vpon-lab/514-Final-Project/Final Project Presentation.pptx

## Wireless Tape Measurer

Veronika Sermeno Pon
TECHIN 514
Final Project
Github Repo: https://github.com/vpon-lab/514-Final-Project

## Measuring alone

- Wanting to measure bedroom space on your own with out another person’s assistance.
- Mitigate sag from a physical tape measurer.

- Problem to Solve:

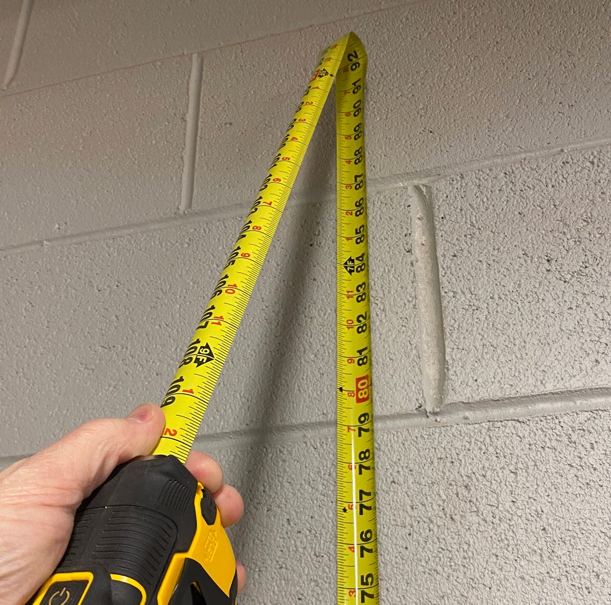
[picture p6: figure]
How to Use a Tape Measure: How to Measure With a Measuring Tape

## Measuring alone

- Wireless tape measurement
- 2-piece system to measure from point A to point B

- A proposed Solution:

General Sketch

Notes: Insert picture once prints are done

## System Architecture


## Sensing + Display Device

Due to multiple ESP32C3 Battery pad mishaps, this is not battery powered for cautionary measures

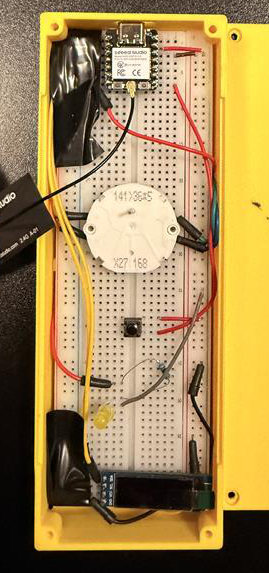
[picture p7: figure]

Display Device

XIAO ESP32C3

Time of Flight Laser Sensor

X27 Stepper Motor

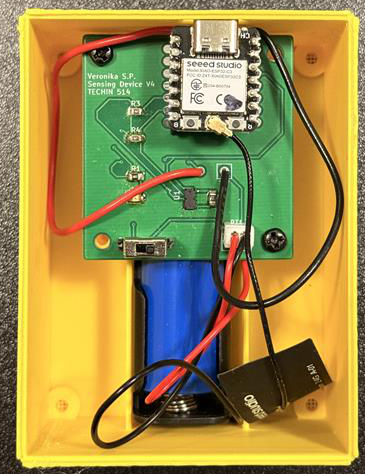
[picture p8: figure]

Sensor Device

“Tare” Button

Power On/Off Switch

OLED Display

Notes: Insert picture once prints are done

## Signal Processing

- Moving average filter, numbers were the same at the first decimal place before filter.
- Accuracy:
  - ±0.01 ft
  - ±3mm
  - Degrades with distance

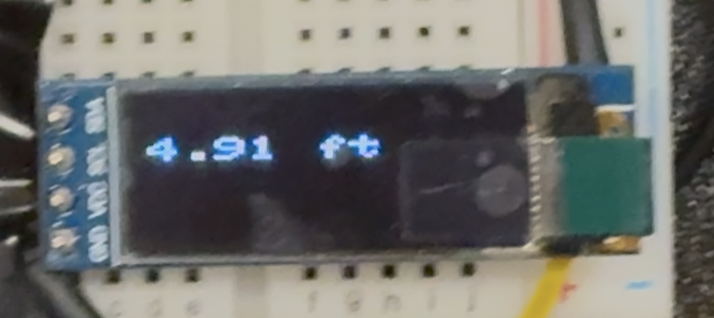
[picture p9: figure]

Display Device shows sensor jumping between measurements – from table to ceiling

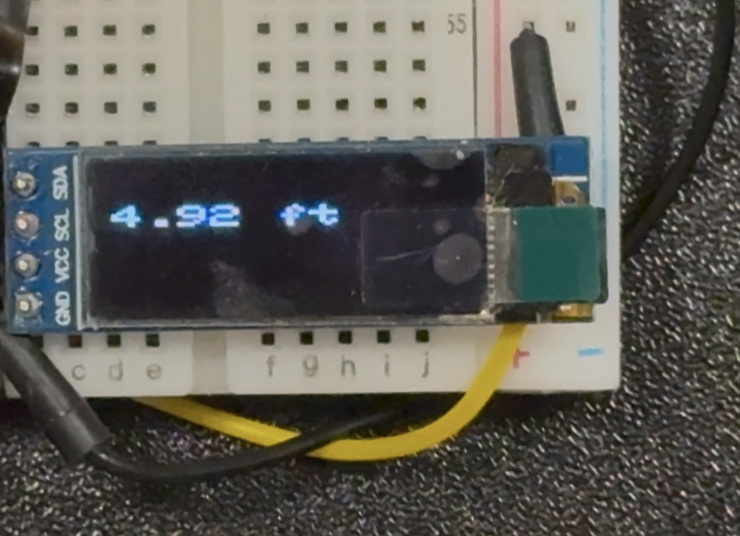
[picture p10: figure]

## Battery Considerations – Sensing device

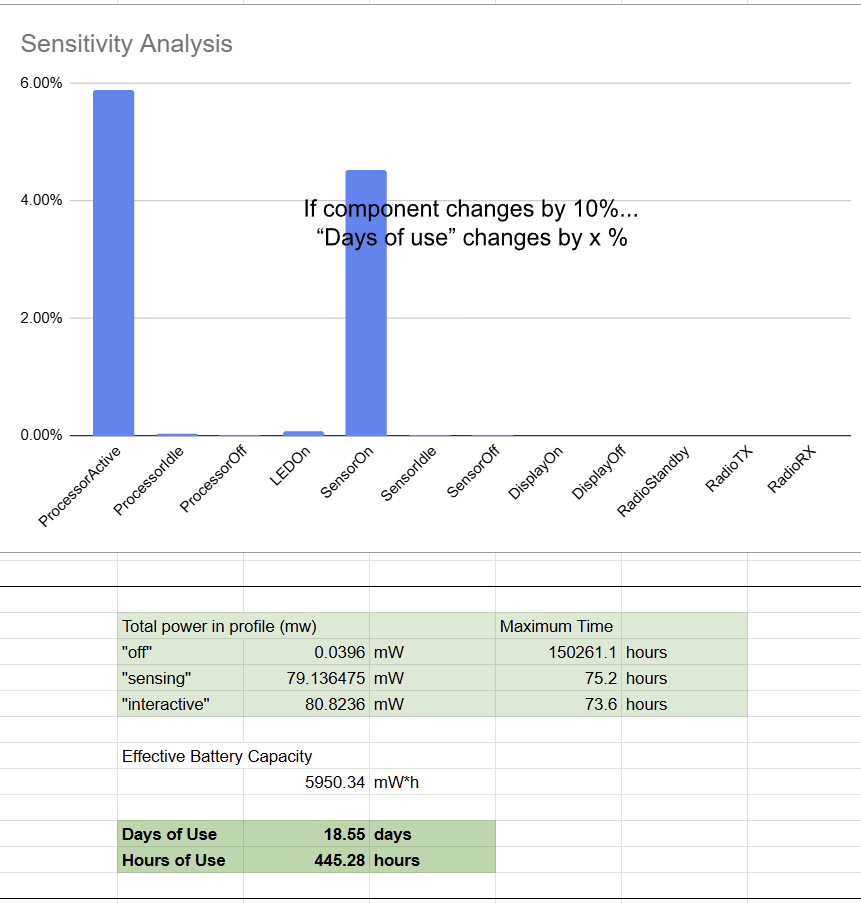
[picture p11: figure]

- 3.7V Lipo or Li-Ion Battery
- Compact easy to design with in enclosure and long lasting
- Based on 2hrs/day of use

## Appendix

- Budget Summary

Anything with “$0” was free in the Maker Space

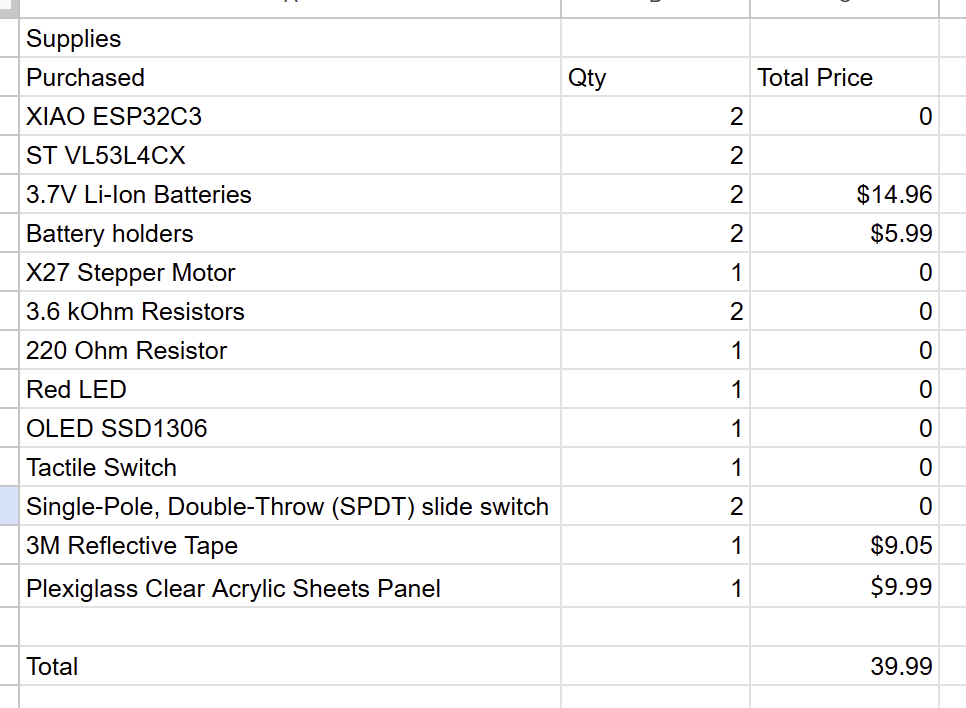
[picture p12: figure]

## Future Work

- Sensor Calibration to get rid of cross-talk from clear acrylic window.
- Sensor Calibration to find max capable distance based on Bluetooth connection compatibility
- Develop a more ergonomic and detachable/portable enclosure(s)
- Proper PCB design for easy battery connection to Display device.

## Appendix

- Power Model (Sensing Device)

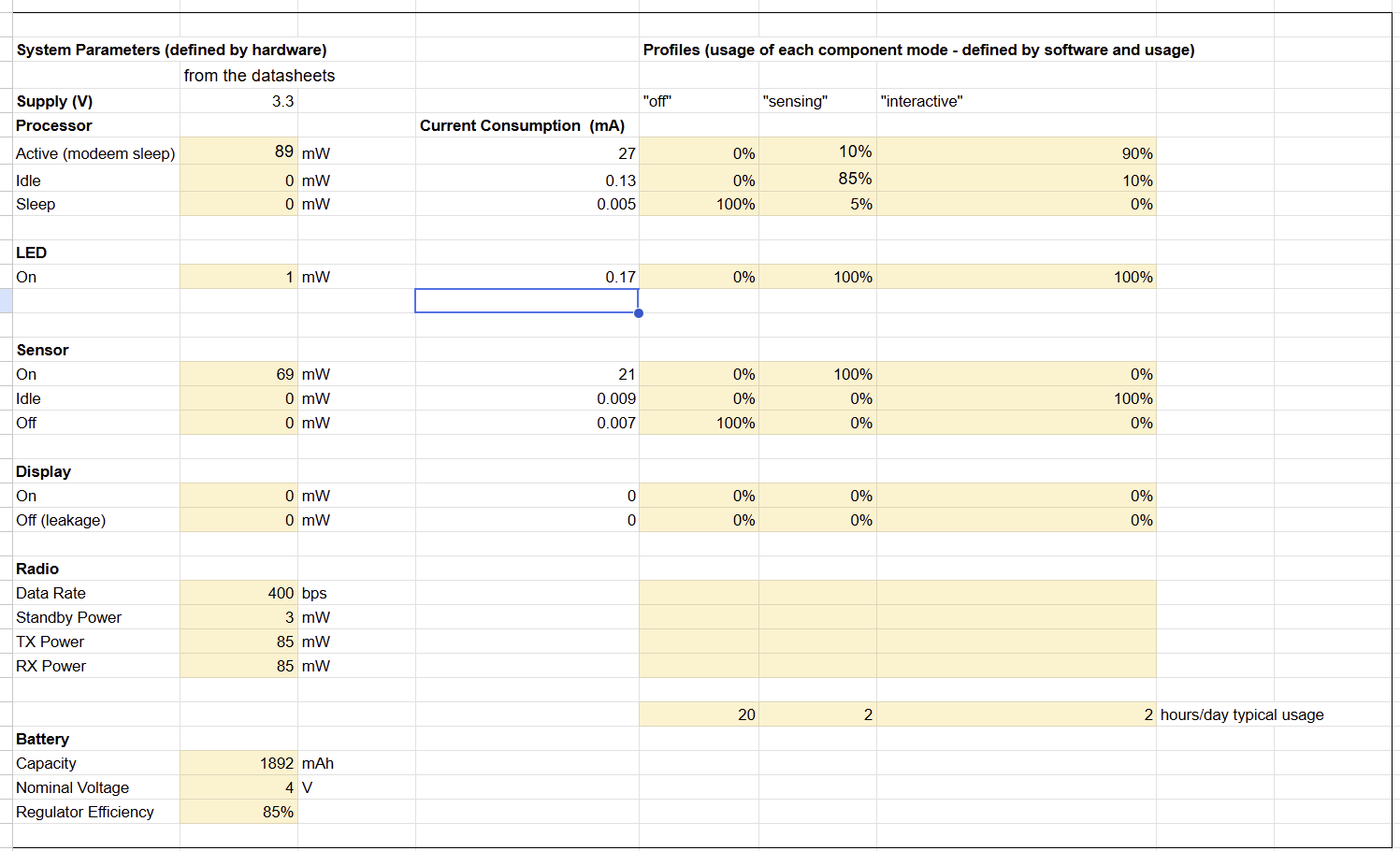
[picture p13: figure]

## Appendix

- Power Model (Display Device) if it were battery powered

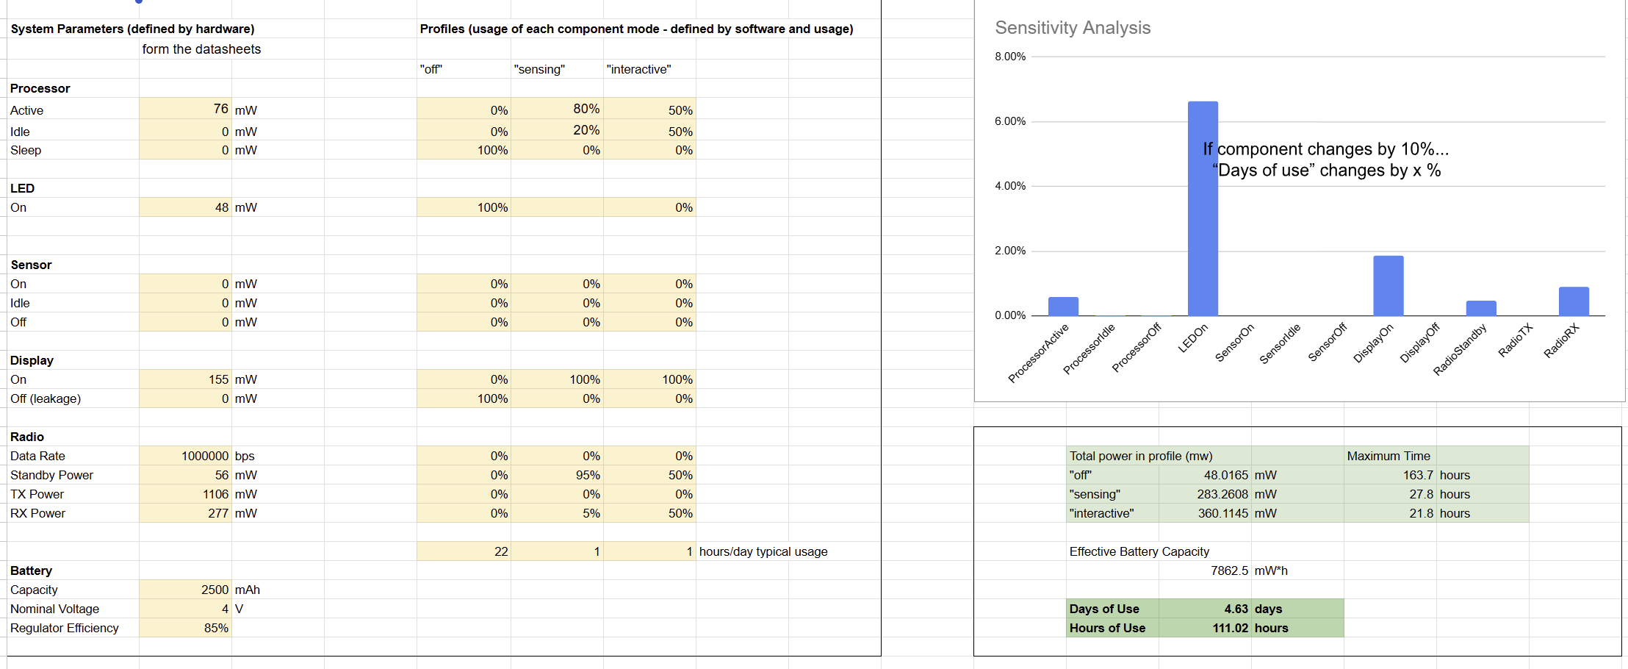
[picture p14: figure]

## Appendix

- Budget Summary

Anything with “$0” was free in the Maker Space

## Appendix

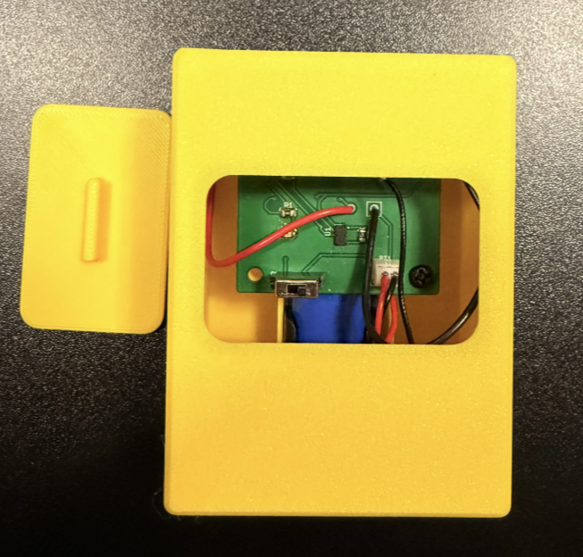
[picture p15: figure]

Sensor Device

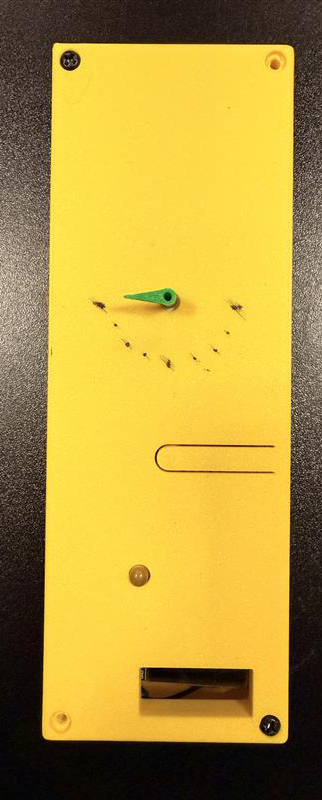
[picture p16: figure]

- Enclosure Design

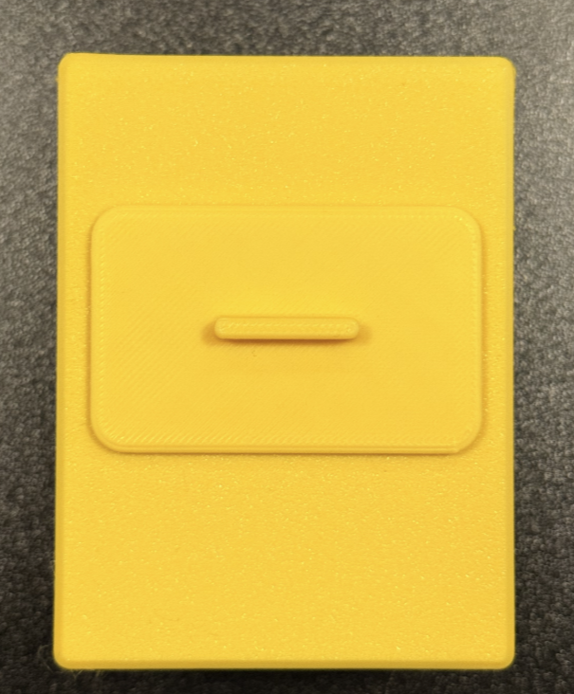
[picture p17: figure]

Display Device

Due to multiple ESP32C3 Battery pad mishaps, this is not battery powered for cautionary measures
