vpon-lab/514-Final-Project/Electrical_schematics/Schematics_display_deviceV3/SensingDevice_V4 (Assembly).step

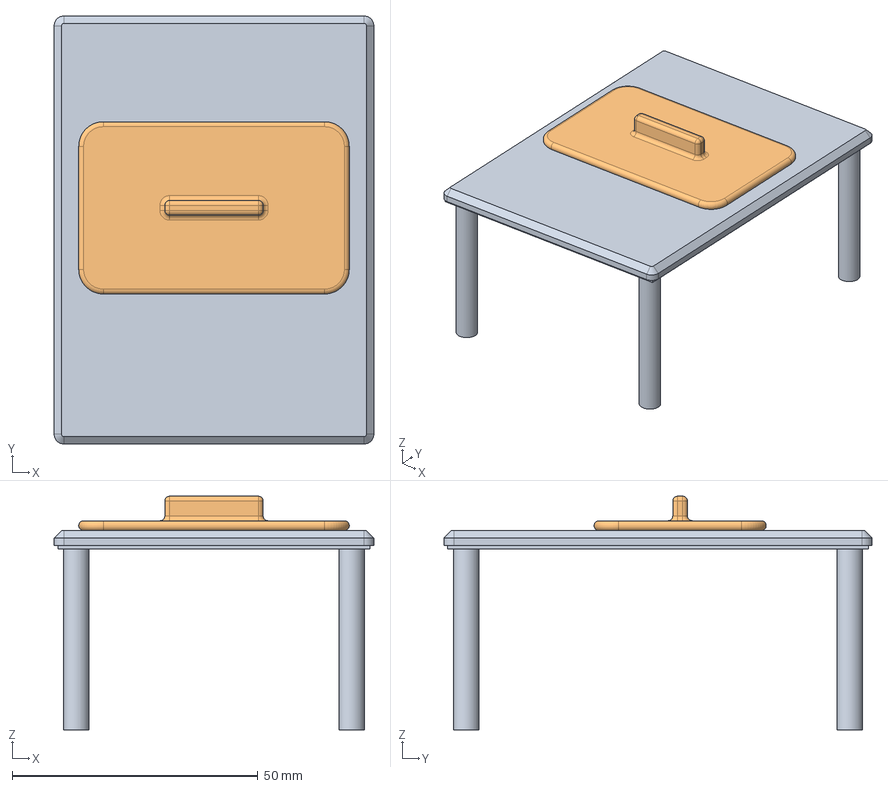
[picture p22: CAD file, 2026-03-16]
Electrical_schematics/Schematics_display_deviceV3/SensingDevice_V4 (Assembly).step
65.0 x 87.0 x 47.5 mm
