vpon-lab/514-Final-Project/Electrical_schematics/Electrical_schematics_V4/SensingDevice_V4 (Assembly).step

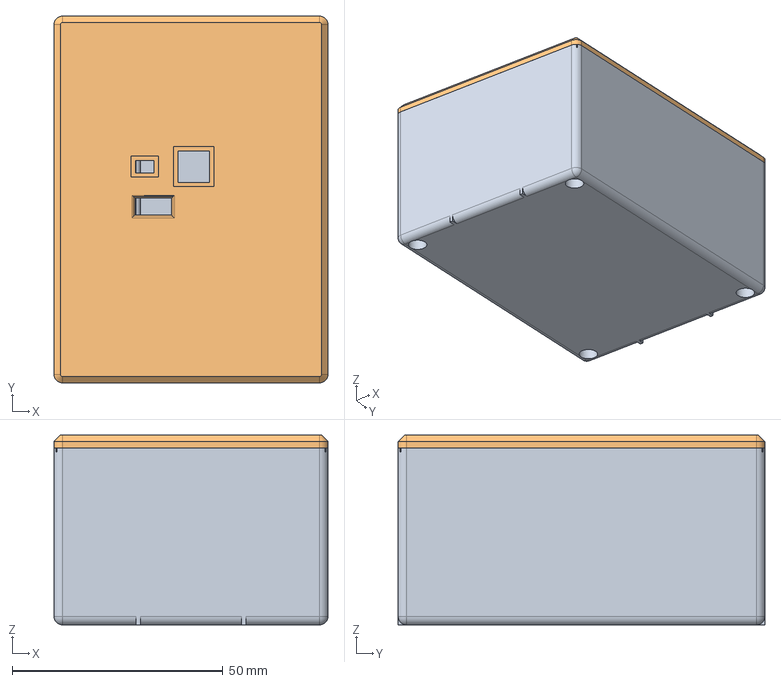
[picture p23: CAD file, 2026-03-16]
Electrical_schematics/Electrical_schematics_V4/SensingDevice_V4 (Assembly).step
65.0 x 87.0 x 45.0 mm
