vpon-lab/514-Final-Project/Electrical_schematics/Schematics_display_deviceV3/DisplayDeviceEnclosure.step

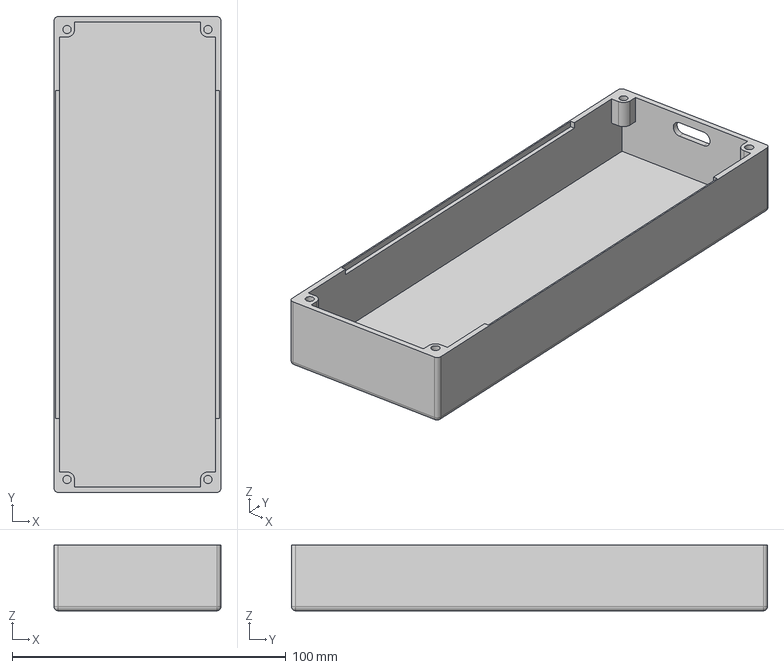
[picture p24: CAD file, 2026-03-16]
Electrical_schematics/Schematics_display_deviceV3/DisplayDeviceEnclosure.step
61.0 x 174.0 x 24.0 mm
