vpon-lab/514-Final-Project/Electrical_schematics/Schematics_display_deviceV3/Schematics_display_deviceV3.step

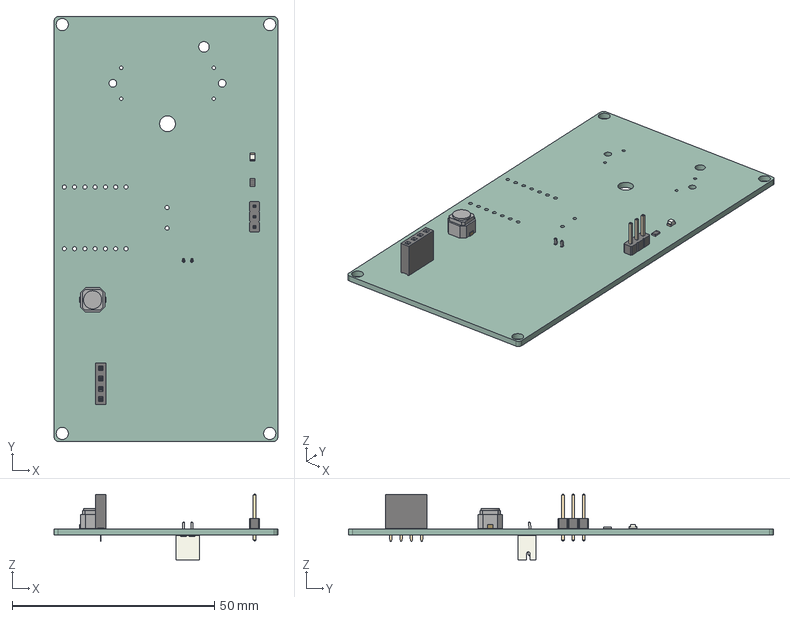
[picture p25: CAD file, 2026-03-16]
Electrical_schematics/Schematics_display_deviceV3/Schematics_display_deviceV3.step
55.2 x 105.0 x 16.2 mm
pin_1
pin_2
LED_0805_2012Metric
PinSocket_1x04_P2.54mm_Vertical
PinHeader_1x03_P2.54mm_Vertical
R_0805_2012Metric
JST_PH_B2B-PH-K_1x02_P2.00mm_Vertical
Schematics_display_deviceV3_PCB
