vpon-lab/514-Final-Project/Electrical_schematics/Schematics_display_deviceV3/DisplayDeviceEnclosure (Needle).step

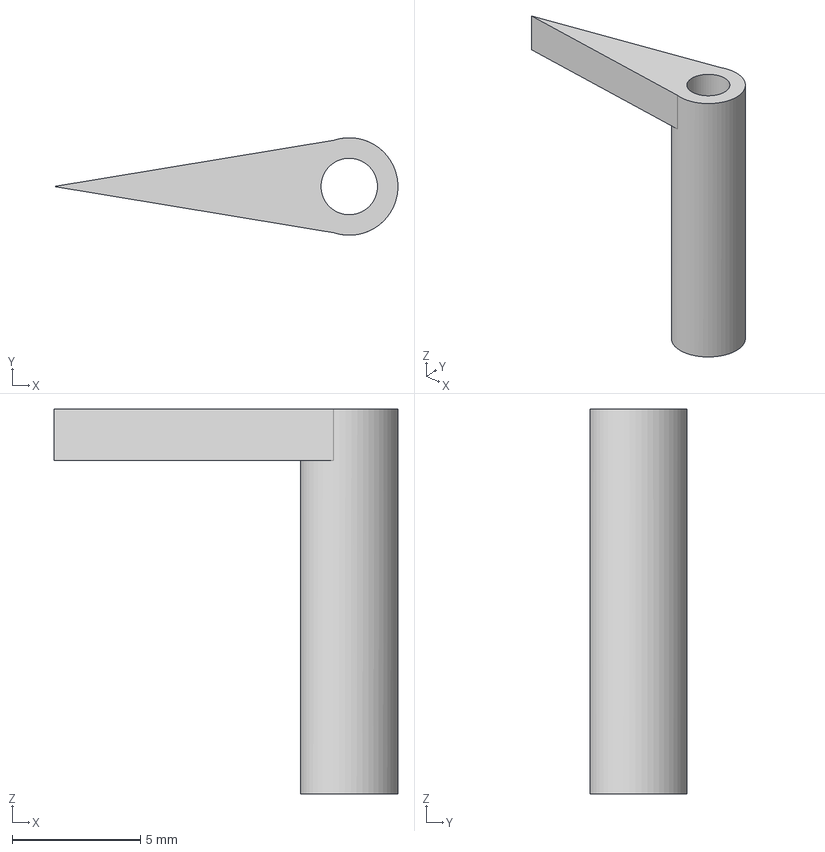
[picture p26: CAD file, 2026-03-16]
Electrical_schematics/Schematics_display_deviceV3/DisplayDeviceEnclosure (Needle).step
13.4 x 3.80 x 15.0 mm
