vpon-lab/514-Final-Project/Electrical_schematics/Schematics_display_deviceV2/Schematics_display_deviceV2.step

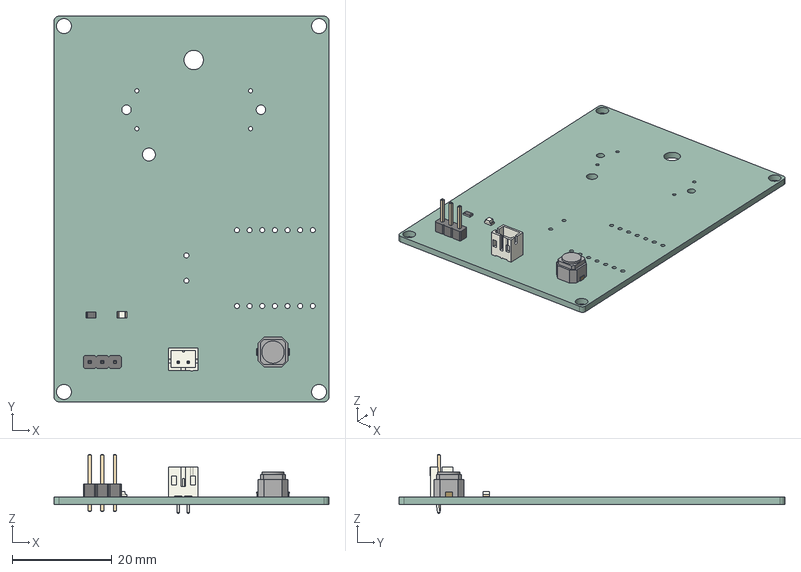
[picture p28: CAD file, 2026-03-05, an earlier design]
Electrical_schematics/Schematics_display_deviceV2/Schematics_display_deviceV2.step
55.2 x 77.5 x 11.9 mm
pin_1
pin_2
LED_0805_2012Metric
PinHeader_1x03_P2.54mm_Vertical
R_0805_2012Metric
JST_PH_B2B-PH-K_1x02_P2.00mm_Vertical
Schematics_display_deviceV2_PCB
