vpon-lab/514-Final-Project/(list of files, cad)

Other CAD files:
Electrical_schematics/Electrical_schematics_V4/SensingDevice_V4 (Lid).step
Electrical_schematics/Electrical_schematics_V4/SensingDevice_V4 (Assembly).3mf
