vpon-lab/514-Final-Project/TECHIN514_PowerModel_DisplayDevice - System Parameters.pdf

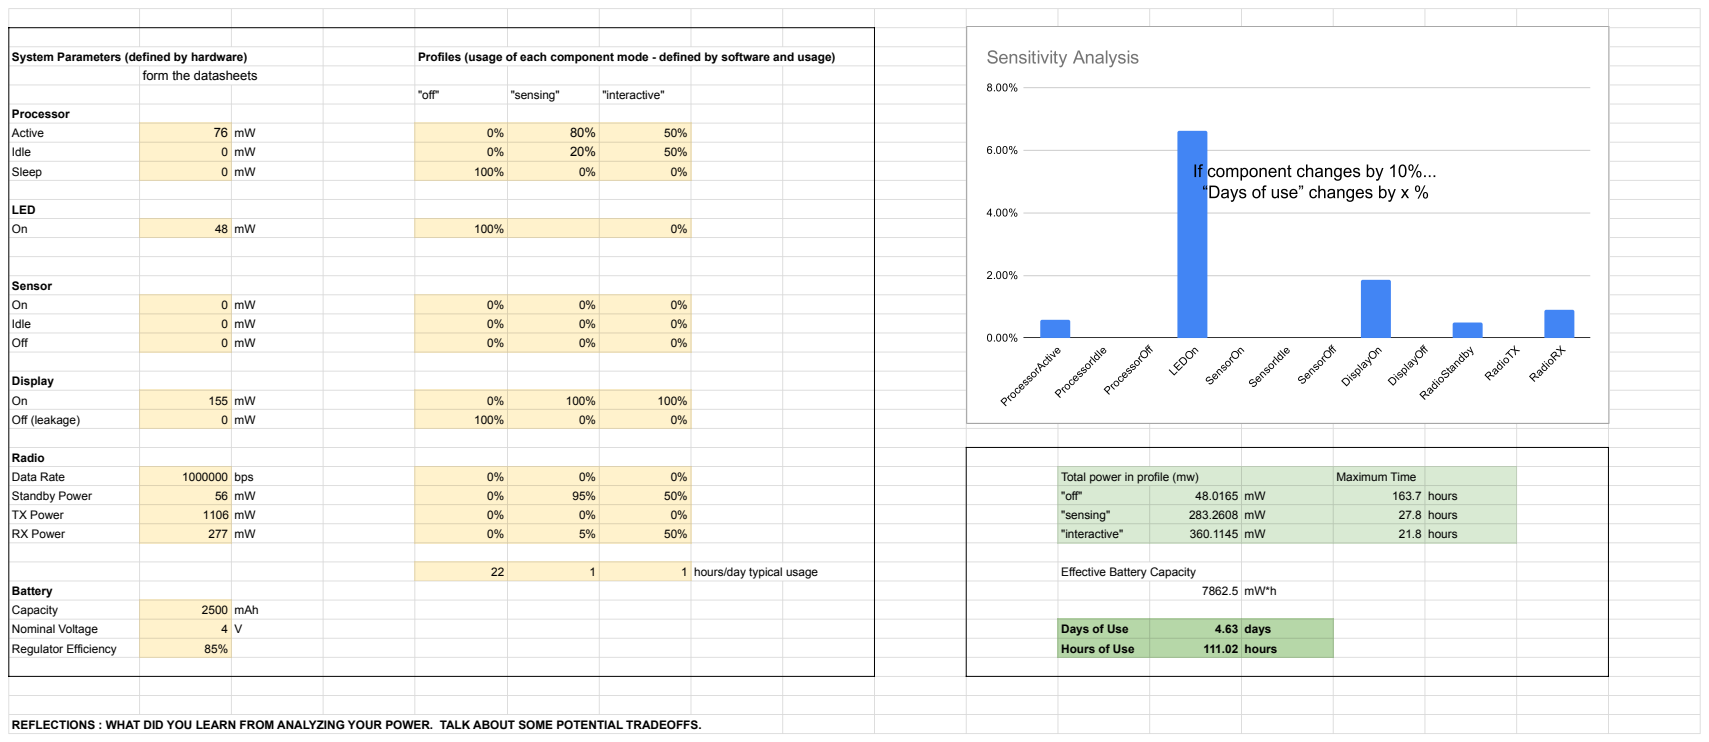
[picture p29: page 1]
System Parameters (defined by hardware); Profiles (usage of each component mode - defined by software and usage); "off"; "sensing"; "interactive"; Processor; Active; Idle; Sleep; LED; Sensor; Off; Display; Off (leakage); Radio; Data Rate; 1000000 bps; Total power in profile (mw); Maximum Time; Standby Power; 163.7 hours; TX Power; 27.8 hours; RX Power; 21.8 hours; 1 hours/day typical usage; Effective Battery Capacity; Battery; Capacity; 2500 mAh; Nominal Voltage; Days of Use; 4.63 days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

form the datasheets

REFLECTIONS : WHAT DID YOU LEARN FROM ANALYZING YOUR POWER. TALK ABOUT SOME POTENTIAL TRADEOFFS.
