vpon-lab/514-Final-Project/_Simple_ Power Model for TECHIN514_SensingDevice - System Parameters (2).pdf

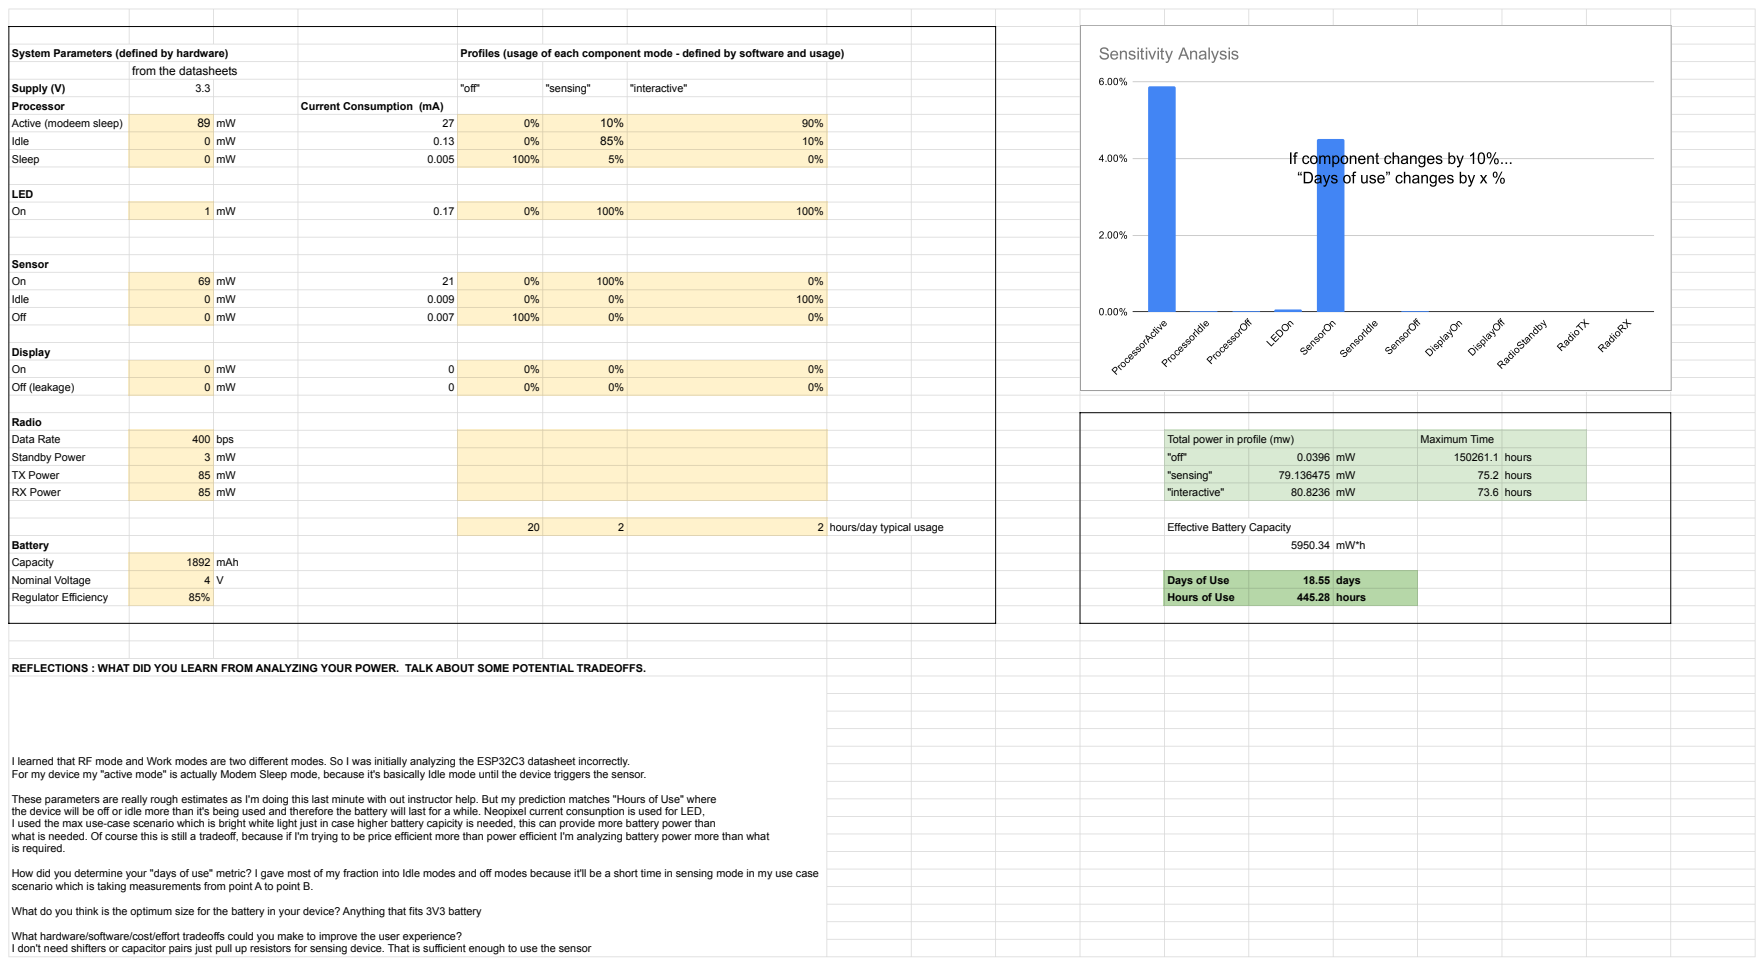
[picture p30: page 1]
System Parameters (defined by hardware); Profiles (usage of each component mode - defined by software and usage); Supply (V); "off"; "sensing"; "interactive"; Processor; Current Consumption (mA); Active (modeem sleep); Idle; Sleep; LED On; Sensor On; Off; Display On; Off (leakage); Radio Data Rate; 400 bps; Total power in profile (mw); Maximum Time; Standby Power; 150261.1 hours; TX Power; 75.2 hours RX Power; 73.6 hours; 2 hours/day typical usage; Effective Battery Capacity Battery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

from the datasheets

REFLECTIONS : WHAT DID YOU LEARN FROM ANALYZING YOUR POWER. TALK ABOUT SOME POTENTIAL TRADEOFFS.

I learned that RF mode and Work modes are two different modes. So I was initially analyzing the ESP32C3 datasheet incorrectly. For my device my "active mode" is actually Modem Sleep mode, because it's basically Idle mode until the device triggers the sensor.

These parameters are really rough estimates as I'm doing this last minute with out instructor help. But my prediction matches "Hours of Use" where
the device will be off or idle more than it's being used and therefore the battery will last for a while. Neopixel current consunption is used for LED,
I used the max use-case scenario which is bright white light just in case higher battery capicity is needed, this can provide more battery power than what is needed. Of course this is still a tradeoff, because if I'm trying to be price efficient more than power efficient I'm analyzing battery power more than what

How did you determine your "days of use" metric? I gave most of my fraction into Idle modes and off modes because it'll be a short time in sensing mode in my use case
scenario which is taking measurements from point A to point B.

What do you think is the optimum size for the battery in your device? Anything that fits 3V3 battery

What hardware/software/cost/effort tradeoffs could you make to improve the user experience?
I don't need shifters or capacitor pairs just pull up resistors for sensing device. That is sufficient enough to use the sensor
