vpon-lab/514-Final-Project/Electrical_schematics/Electrical_schematics_V2/Schematics.pdf

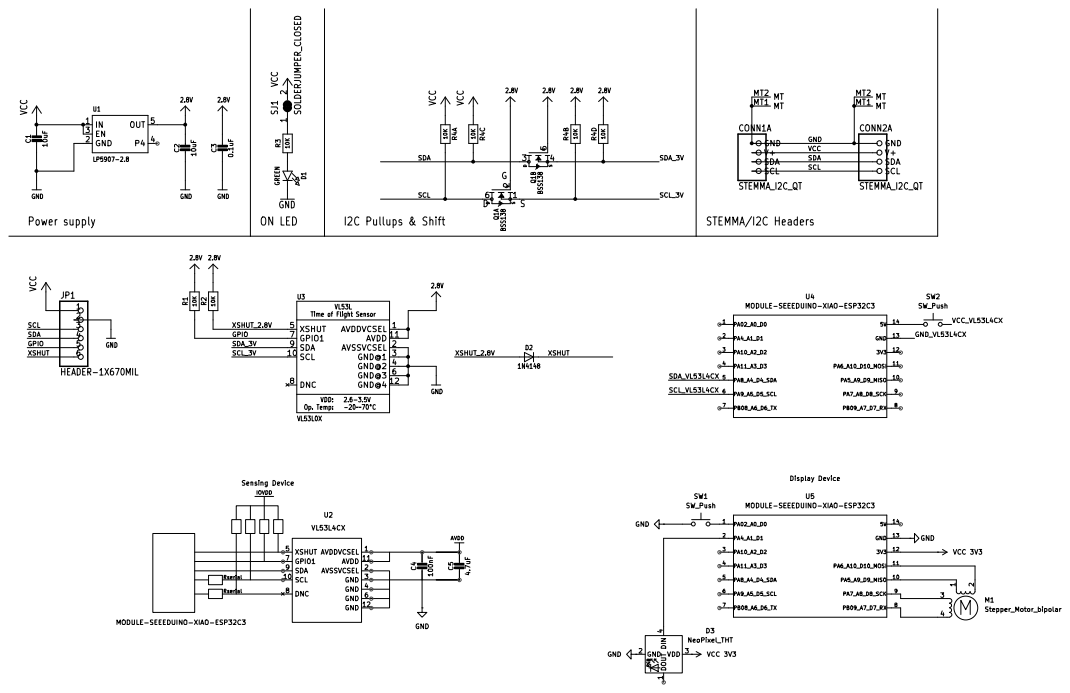
[picture p31: page 1]
