vpon-lab/514-Final-Project/Electrical_schematics/Schematics_display_deviceV3/Schematics_display_deviceV3.kicad_pcb

## KiCad design Electrical_schematics/Schematics_display_deviceV3/Schematics_display_deviceV3.kicad_pcb (2026-03-16)

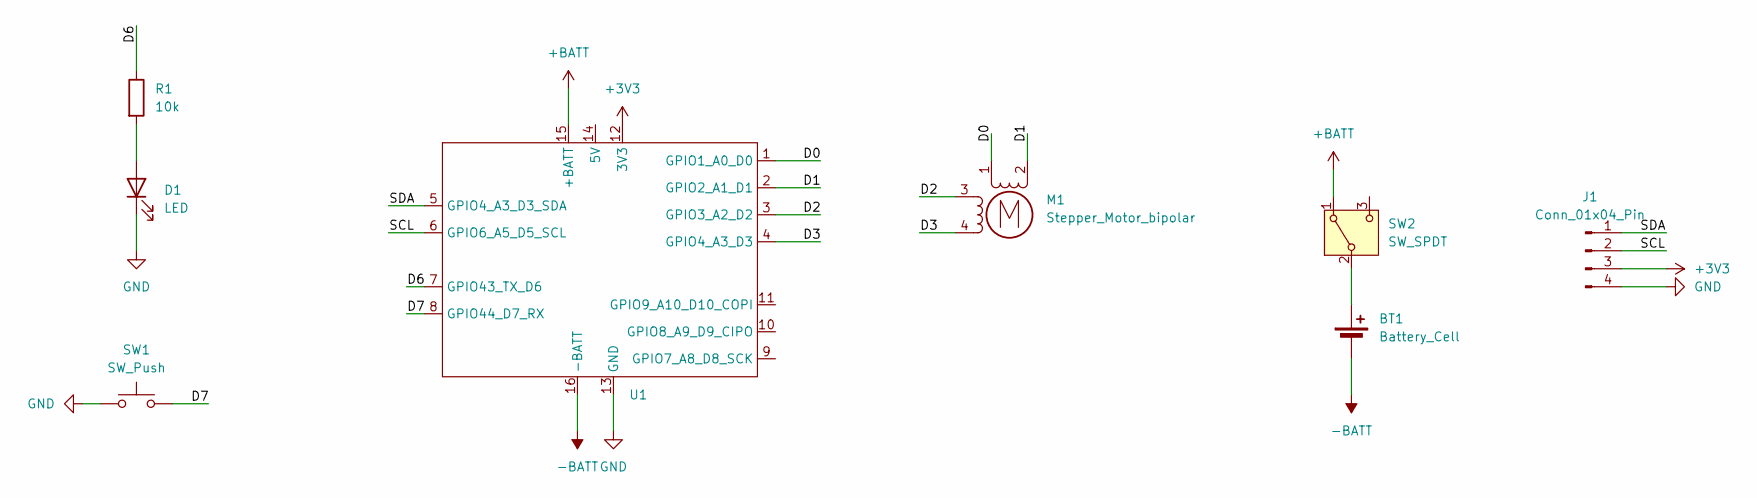
[picture p32: schematic Schematics_display_deviceV3.kicad_sch]

Parts:
BT1: Battery_Cell; JST_PH_B2B-PH-K_1x02_P2.00mm_Vertical
D1: LED; LED_0805_2012Metric_Pad1.15x1.40mm_HandSolder
J1: Conn_01x04_Pin; PinSocket_1x04_P2.54mm_Vertical
M1: Stepper_Motor_bipolar; x27_stepper
R1: 10k; R_0805_2012Metric_Pad1.20x1.40mm_HandSolder
SW1: SW_Push; SW_Push_1TS009xxxx-xxxx-xxxx_6x6x5mm
SW2: SW_SPDT; PinHeader_1x03_P2.54mm_Vertical
U1: XIAO_ESP32

Connections:
+3V3: J1.3, U1.12 (3V3)
+BATT: SW2.1 (A), U1.15 (+BATT)
-BATT: BT1.2 (-), U1.16 (-BATT)
/D0: M1.1, U1.1 (GPIO1_A0_D0)
/D1: M1.2 (-), U1.2 (GPIO2_A1_D1)
/D2: M1.3, U1.3 (GPIO3_A2_D2)
/D3: M1.4, U1.4 (GPIO4_A3_D3)
/D6: R1.1, U1.7 (GPIO43_TX_D6)
/D7: SW1.2, U1.8 (GPIO44_D7_RX)
/SCL: J1.2, U1.6 (GPIO6_A5_D5_SCL)
/SDA: J1.1, U1.5 (GPIO4_A3_D3_SDA)
GND: D1.1 (K), J1.4, SW1.1, U1.13 (GND)
unnamed: BT1.1 (+), SW2.2 (B)
unnamed: D1.2 (A), R1.2

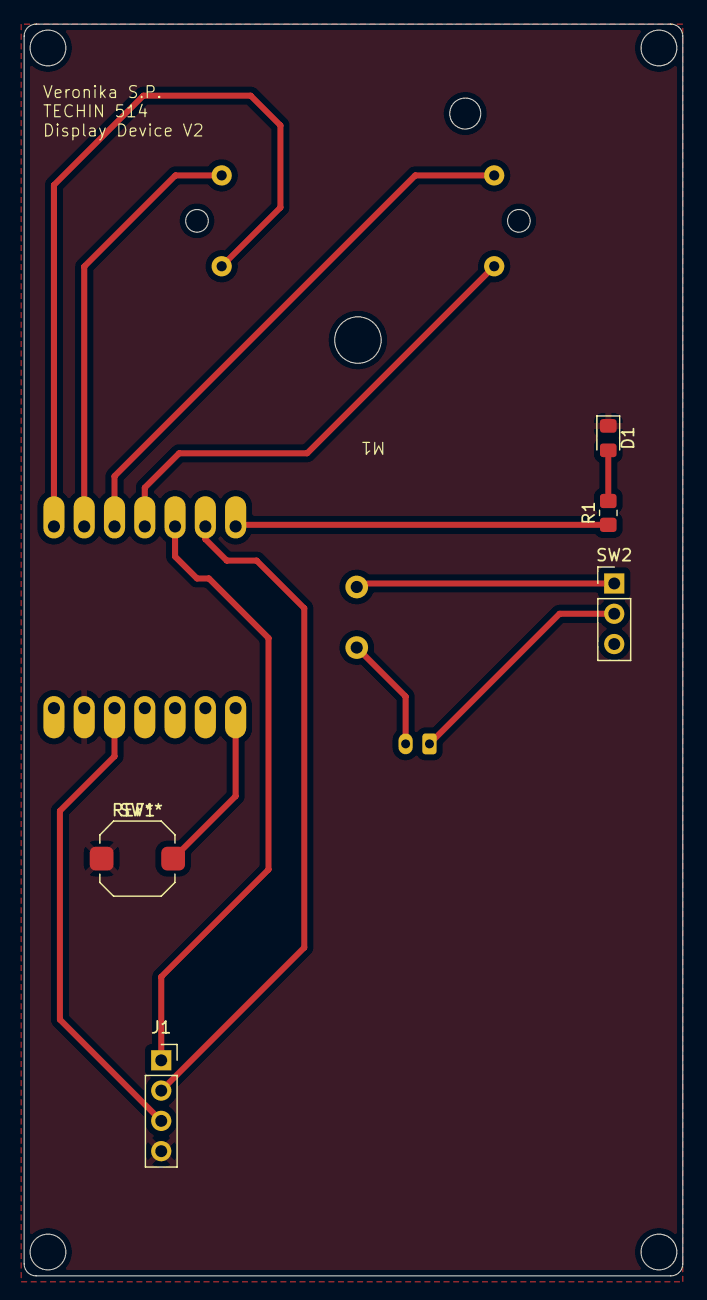
[picture p33: board Schematics_display_deviceV3.kicad_pcb from above]

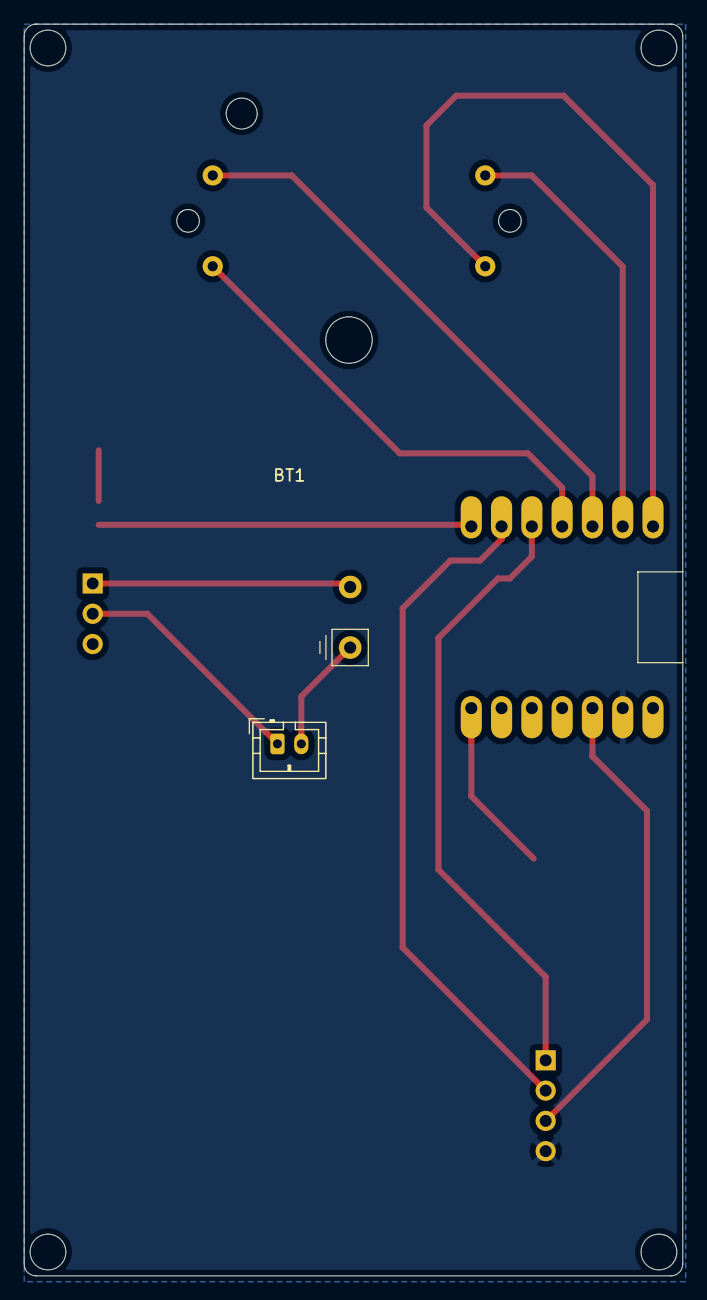
[picture p34: board Schematics_display_deviceV3.kicad_pcb from below]

Board: 2 copper layers, 55.2 x 105.0 mm, 8 parts (2 on the bottom side), 14 nets.
