vpon-lab/514-Final-Project/Electrical_schematics/Schematics_display_device/Schematics_display_device.kicad_pcb

## KiCad design Electrical_schematics/Schematics_display_device/Schematics_display_device.kicad_pcb (2026-03-01, an earlier design)

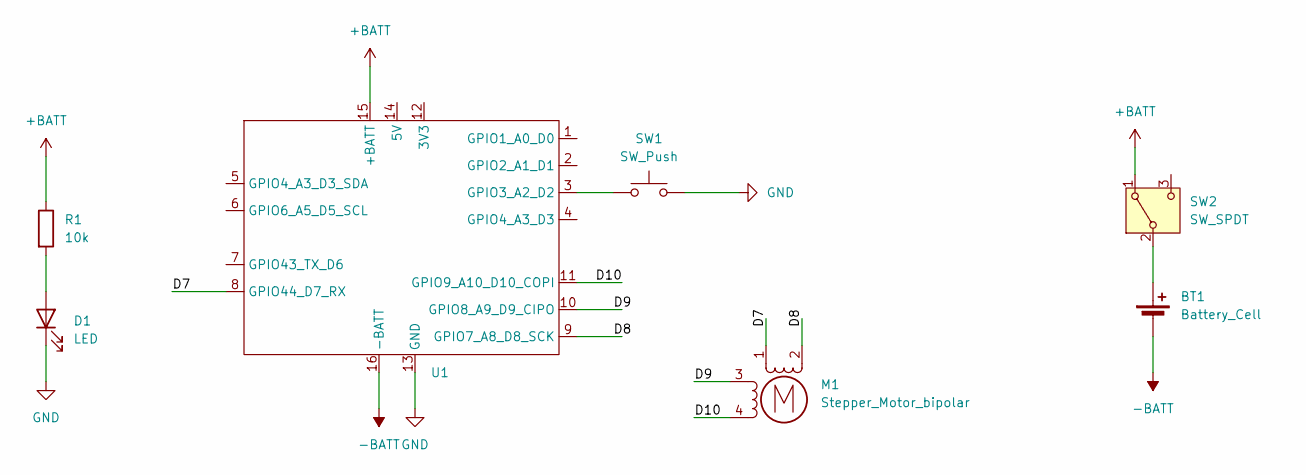
[picture p35: schematic Schematics_display_device.kicad_sch]

Parts:
BT1: Battery_Cell; JST_PH_B2B-PH-K_1x02_P2.00mm_Vertical
D1: LED; LED_0805_2012Metric_Pad1.15x1.40mm_HandSolder
M1: Stepper_Motor_bipolar; x27_stepper
R1: 10k; R_0805_2012Metric_Pad1.20x1.40mm_HandSolder
SW1: SW_Push; SW_Push_1TS009xxxx-xxxx-xxxx_6x6x5mm
SW2: SW_SPDT; PinHeader_1x03_P2.54mm_Vertical
U1: XIAO_ESP32

Connections:
+BATT: R1.1, SW2.1 (A), U1.15 (+BATT)
-BATT: BT1.2 (-), U1.16 (-BATT)
/D7: M1.1, U1.8 (GPIO44_D7_RX)
/D8: M1.2 (-), U1.9 (GPIO7_A8_D8_SCK)
/D9: M1.3, U1.10 (GPIO8_A9_D9_CIPO)
/D10: M1.4, U1.11 (GPIO9_A10_D10_COPI)
GND: D1.1 (K), SW1.2, U1.13 (GND)
unnamed: BT1.1 (+), SW2.2 (B)
unnamed: D1.2 (A), R1.2
unnamed: SW1.1, U1.3 (GPIO3_A2_D2)

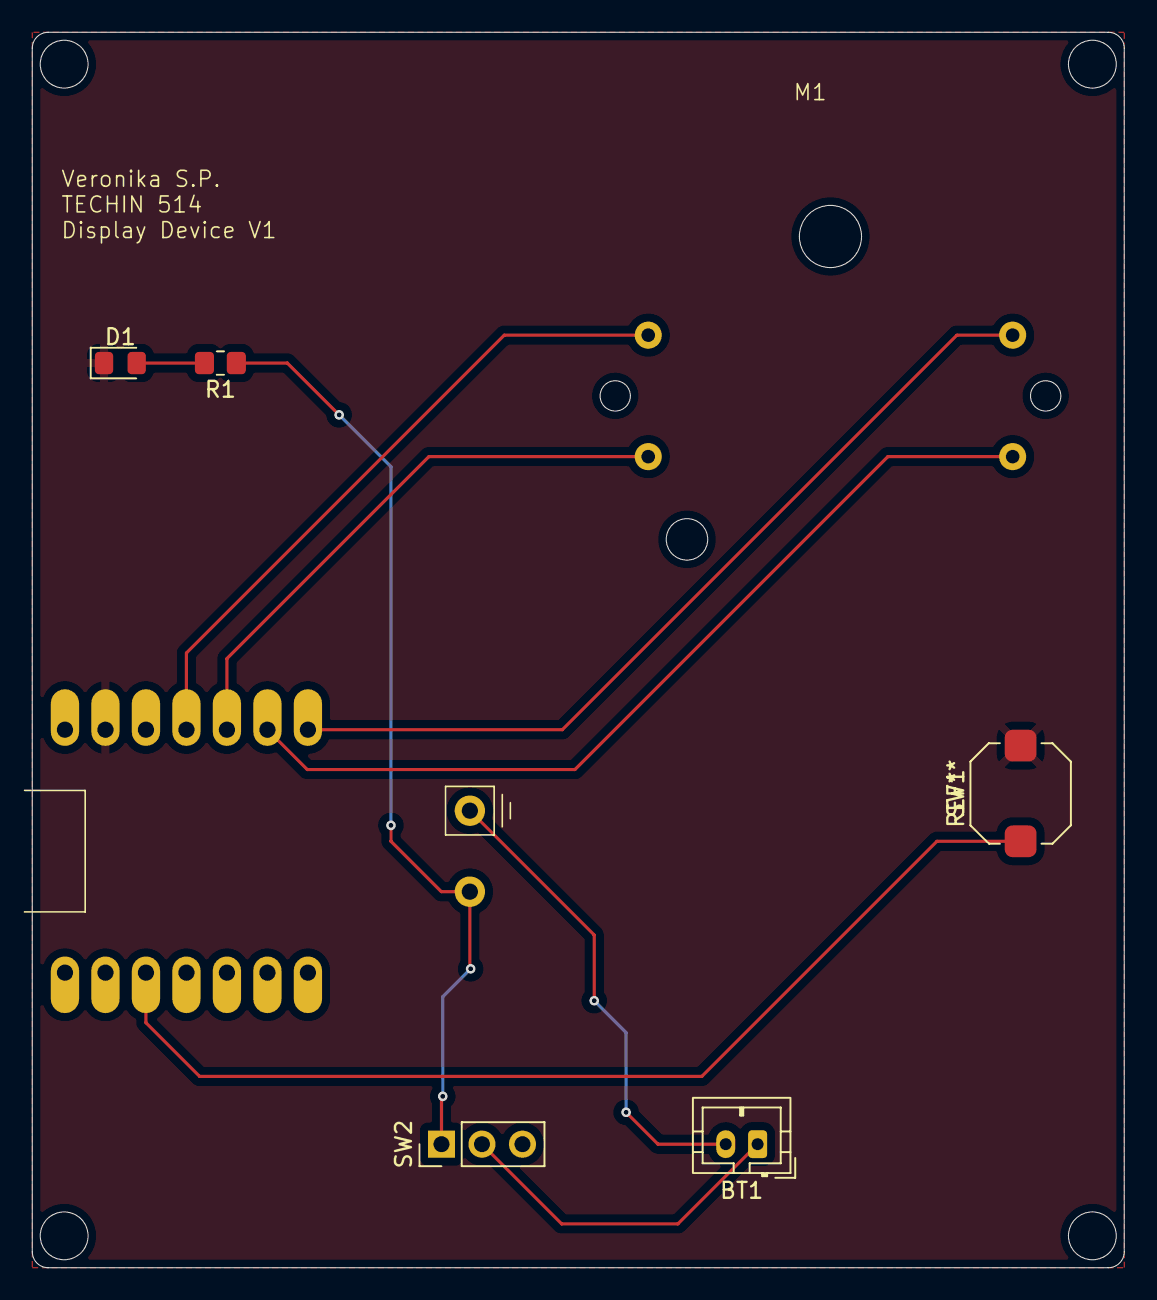
[picture p36: board Schematics_display_device.kicad_pcb from above]

Board: 2 copper layers, 68.5 x 77.5 mm, 7 parts (0 on the bottom side), 10 nets.
