vpon-lab/514-Final-Project/Electrical_schematics/Electrical_schematics_V4/Electrical_schematics_V4.kicad_pcb

## KiCad design Electrical_schematics/Electrical_schematics_V4/Electrical_schematics_V4.kicad_pcb (2026-02-23)

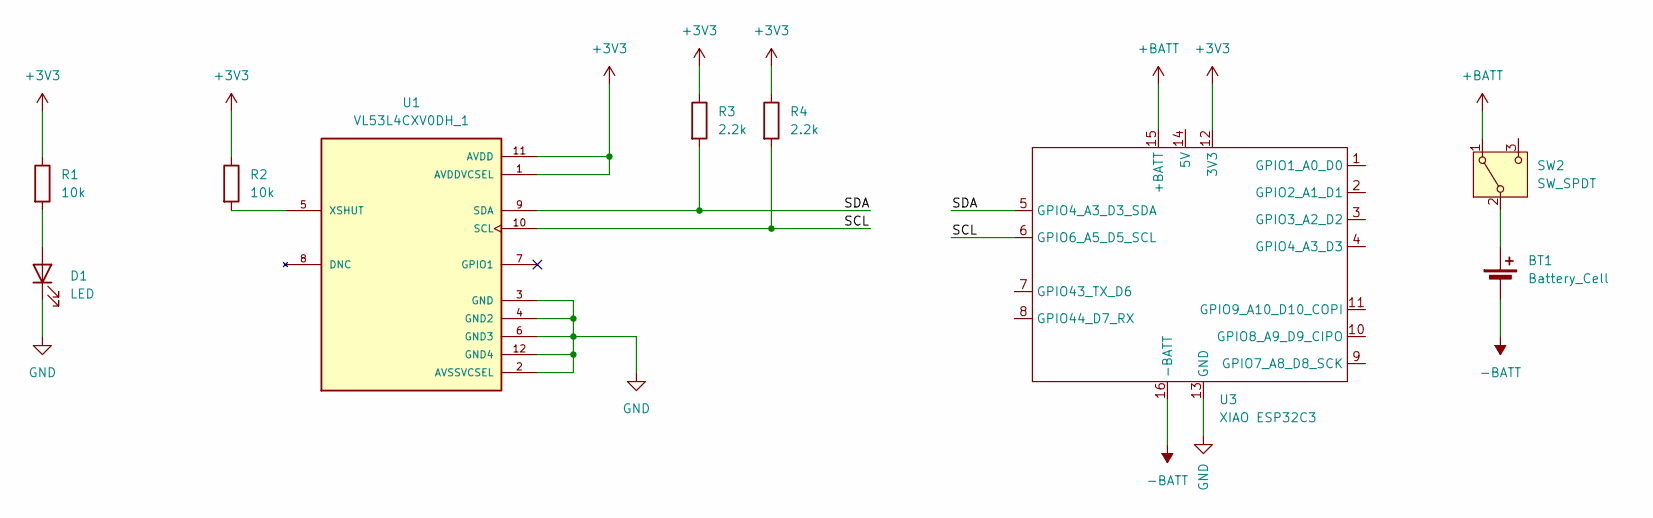
[picture p37: schematic Electrical_schematics_V4.kicad_sch, Sensing Device Schematic]

Parts:
BT1: Battery_Cell; JST_PH_B2B-PH-K_1x02_P2.00mm_Vertical
D1: LED; LED_0805_2012Metric_Pad1.15x1.40mm_HandSolder
R1, R2: 10k; R_0805_2012Metric_Pad1.20x1.40mm_HandSolder
R3, R4: 2.2k; R_0805_2012Metric_Pad1.20x1.40mm_HandSolder
SW2: SW_SPDT; PinHeader_1x03_P2.54mm_Vertical
U1: VL53L4CXV0DH_1; XCDR_VL53L4CXV0DH_1; PARTREV 4
U3: XIAO ESP32C3; XIAO_ESP32

Connections:
+3V3: R1.1, R2.1, R3.1, R4.1, U1.1 (AVDDVCSEL), U1.11 (AVDD), U3.12 (3V3)
+BATT: SW2.1 (A), U3.15 (+BATT)
-BATT: BT1.2 (-), U3.16 (-BATT)
/SCL: R4.2, U1.10 (SCL), U3.6 (GPIO6_A5_D5_SCL)
/SDA: R3.2, U1.9 (SDA), U3.5 (GPIO4_A3_D3_SDA)
GND: D1.1 (K), U1.2 (AVSSVCSEL), U1.3 (GND), U1.4 (GND2), U1.6 (GND3), U1.12 (GND4), U3.13 (GND)
unnamed: BT1.1 (+), SW2.2 (B)
unnamed: D1.2 (A), R1.2
unnamed: R2.2, U1.5 (XSHUT)

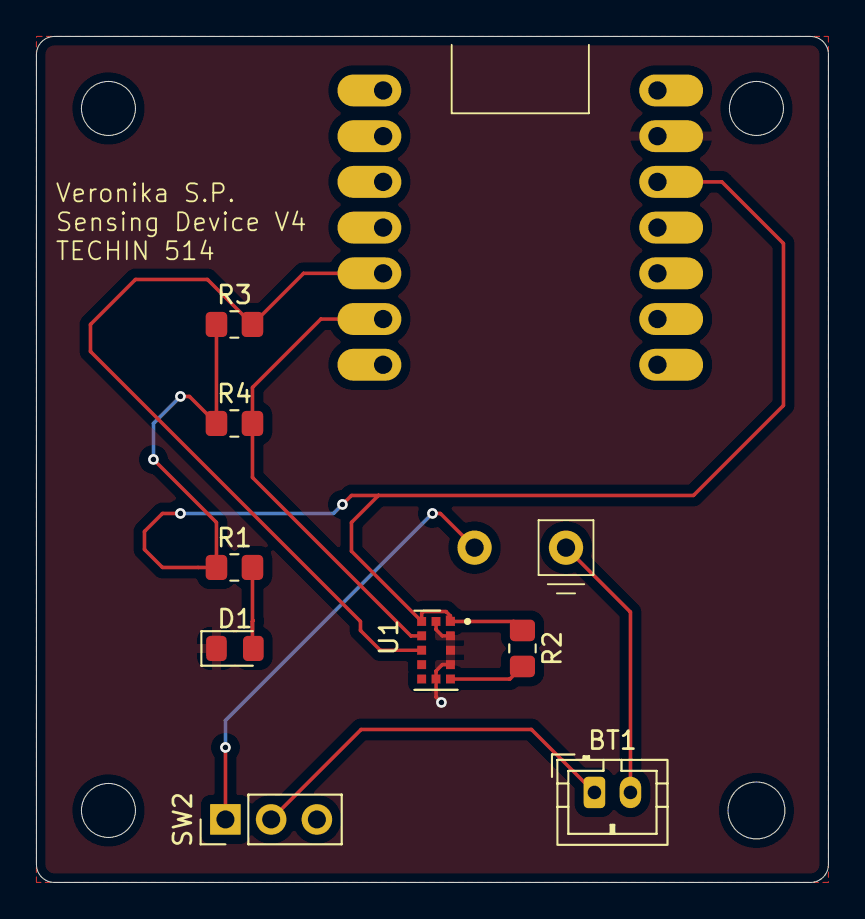
[picture p38: board Electrical_schematics_V4.kicad_pcb from above]

Board: 2 copper layers, 44.0 x 47.0 mm, 9 parts (0 on the bottom side), 9 nets.
