vpon-lab/514-Final-Project/Electrical_schematics/Electrical_schematics_V2/Electrical_schematics_V2.kicad_pcb

## KiCad design Electrical_schematics/Electrical_schematics_V2/Electrical_schematics_V2.kicad_pcb (2026-02-09, an earlier design)

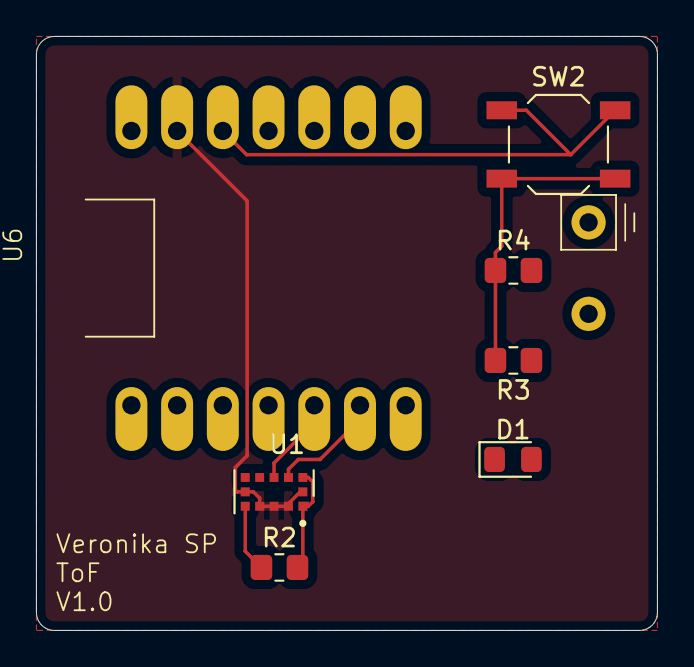
[picture p39: board Electrical_schematics_V2.kicad_pcb from above]

Board: 2 copper layers, 34.5 x 33.0 mm, 7 parts (0 on the bottom side), 7 nets.

Parts:
D1: GREEN; LED_0805_2012Metric_Pad1.15x1.40mm_HandSolder
R2, R3: 10K; R_0805_2012Metric_Pad1.20x1.40mm_HandSolder
R4: 3.6K; R_0805_2012Metric_Pad1.20x1.40mm_HandSolder
SW2: SW_Push; SW_SPST_TL3342
U1: VL53L4CXV0DH_1; XCDR_VL53L4CXV0DH_1
U6: XIAO ESP32C3; XIAO_ESP32

Connections:
3.3V: R2.2, U1.1 (AVDDVCSEL), U1.11 (AVDD)
/SCL: U1.10 (SCL), U6.6 (D5)
/SDA: U1.9 (SDA), U6.5 (D4)
/XSHUT_2.8V: R2.1, U1.5 (XSHUT)
GND: U1.2 (AVSSVCSEL), U1.3 (GND), U1.4 (GND2), U1.6 (GND3), U1.12 (GND4), U6.13 (GND)
unnamed: SW2.1, U6.12 (VCC_3V3)
VCC: R3.2, R4.1, SW2.2
