vpon-lab/514-Final-Project/(commit log)

2026-01-27 Added schematics, and made a BOM to the best of my abilities.
    [Electrical_schematics.csv, Electrical_schematics.kicad_pcb, Electrical_schematics.kicad_sch, Electrical_schematics.xlsx]
2026-01-27 changing battery value because voltage is unknown need help figuring that out
2026-01-27 updated pdf for system architecture and pdf for schematics
    [Electrical_schematics.kicad_sch]
2026-02-09 I've added data sheets and made a 2nd version of my schematic a while ago I think I forgot to commit
    [Adafruit VL53L4CX.kicad_sch, BOMElectrical_schematics_V2.xlsx, Electrical_schematics_V2.csv, Electrical_schematics_V2.kicad_pcb, Electrical_schematics_V2.kicad_sch, Electrical_schematics_V2.xlsx]
2026-02-09 adding excel sheet of Battery Life Estimate into github repo
    [_Simple_ Power Model for TECHIN514_SensingDevice.xlsx]
2026-02-20 file changes to PCB version history
    [Electrical_schematics_V2.csv, Electrical_schematics_V2.kicad_pcb, Electrical_schematics_V2.kicad_sch, Electrical_schematics_V2.xlsx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]
2026-02-23 added data sheets and new version of sensing schematic
    [Electrical_schematics_V4-B_Cu.gbr, Electrical_schematics_V4-B_Mask.gbr, Electrical_schematics_V4-B_Paste.gbr, Electrical_schematics_V4-B_Silkscreen.gbr, Electrical_schematics_V4-Edge_Cuts.gbr, Electrical_schematics_V4-F_Cu.gbr, Electrical_schematics_V4-F_Mask.gbr, Electrical_schematics_V4-F_Paste.gbr]
2026-03-01 added datasheets, new schematics, and displaydevice project
    [Schematics_display_device-B_Cu.gbr, Schematics_display_device-B_Mask.gbr, Schematics_display_device-B_Paste.gbr, Schematics_display_device-B_Silkscreen.gbr, Schematics_display_device-Edge_Cuts.gbr, Schematics_display_device-F_Cu.gbr, Schematics_display_device-F_Mask.gbr, Schematics_display_device-F_Paste.gbr]
2026-03-05 added 2nd version of schematics of display device
    [Schematics_display_deviceV2-B_Cu.gbr, Schematics_display_deviceV2-B_Mask.gbr, Schematics_display_deviceV2-B_Paste.gbr, Schematics_display_deviceV2-B_Silkscreen.gbr, Schematics_display_deviceV2-Edge_Cuts.gbr, Schematics_display_deviceV2-F_Cu.gbr, Schematics_display_deviceV2-F_Mask.gbr, Schematics_display_deviceV2-F_Paste.gbr]
2026-03-09 display device code furnished. Improvements can be made after making enclosure.
2026-03-16 display and sensing device code done. Added presentation slides.
    [DisplayDeviceEnclosure (Needle).step, DisplayDeviceEnclosure.step, Electrical_schematics_V4.step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]
2026-03-16 updated power model for sensing device
    [_Simple_ Power Model for TECHIN514_SensingDevice.xlsx]
2026-03-16 edited presentation, added power model for display device
